mic-e/debugger9k1/board_v2/history.md

3 pcs ordered from Aisler at 2021-11-27
5 pcs ordered from JLCPCB at 2021-11-28

1 pc (Aisler) assembled at march - may 2022
