mic-e/debugger9k1/board_v2/board.kicad_pcb

## KiCad design board_v2/board.kicad_pcb (2022-05-30)

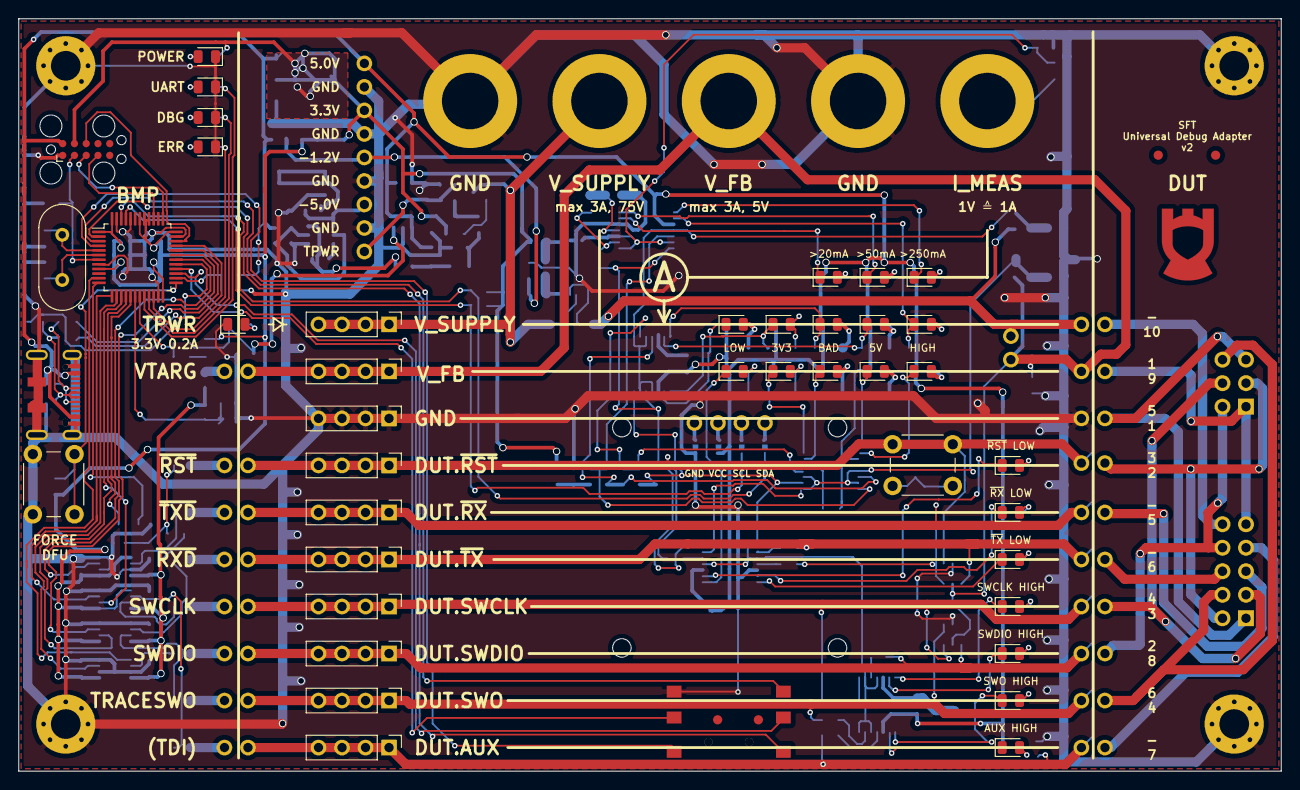
[picture p1: board board.kicad_pcb from above]

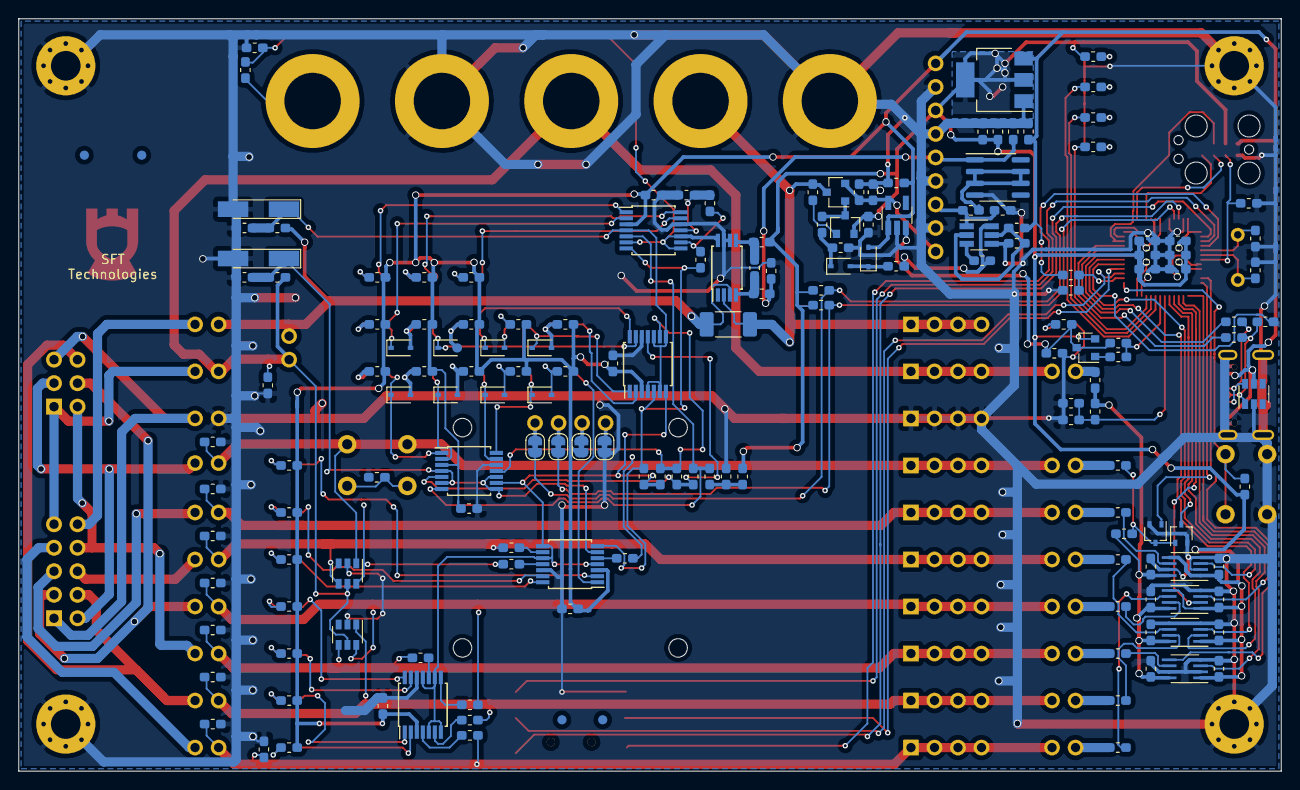
[picture p2: board board.kicad_pcb from below]

Board: 2 copper layers, 136.4 x 81.3 mm, 246 parts (167 on the bottom side), 157 nets.

Parts:
C1, C5, C7, C8, C9, C10, C11, C12, C13, C14, C15, C16, C17, C18, C19, C20, C21, C22, C23, C24, C25, C33, C34, C35, C36: 100nF; C_0603_1608Metric_Pad1.05x0.95mm_HandSolder
C2, C3: 18pF; C_0603_1608Metric_Pad1.05x0.95mm_HandSolder
C4, C6, C26, C29, C30, C31: 4.7uF; C_0603_1608Metric_Pad1.05x0.95mm_HandSolder
C27, C28: 10uF; C_0603_1608Metric_Pad1.05x0.95mm_HandSolder
C32: 1uF; C_0603_1608Metric_Pad1.05x0.95mm_HandSolder
D1, D6, D8, D15, D18, D20, D39: Green; LED_0805_2012Metric
D2, D3, D9, D10, D11, D14, D22, D23, D24, D25: Yellow; LED_0805_2012Metric
D4, D5, D7, D12, D13, D17, D19, D21: Red; LED_0805_2012Metric
D16, D26: 4.7V; D_MiniMELF_Handsoldering
D27, D29, D38: 24V ESD; R_0603_1608Metric_Pad1.05x0.95mm_HandSolder
D30, D31, D32, D33, D34, D35, D36, D37, D40, D41: 1N4148WS; D_SOD-323
FB1, FB2, FB3, FB4, FB5: 30Ω@100MHz; R_0603_1608Metric_Pad1.05x0.95mm_HandSolder
FID1, FID2, FID3, FID4, FID5, FID6, FID7, FID8: Fiducial; Fiducial_1mm_Mask2mm
H1, H2, H3, H4: MountingHole_Pad; MountingHole_3.2mm_M3_Pad_Via
J1: DX07S016JA; USB_C_JAE_DX07S0116JA1
J3, J4, J5, J6, J7, J8, J9, J10, J11, J12: Conn_01x04_Male; PinHeader_1x04_P2.54mm_Vertical
J13, J14, J15, J16, J17: Conn_01x01_Female; Connector_Banana_SKS_BIL20
J18: Conn_01x09; PinHeader_1x09_P2.54mm_Vertical
JP1, JP2, JP3, JP4, JP5, JP6, JP7, JP8, JP9, JP10, JP11, JP12, JP13, JP14, JP15, JP16, JP17, JP18, JP19: Jumper_NC_Small; Jumper_2.54mm
JP20, JP21, JP22, JP23: SolderJumper_2_Bridged; SolderJumper-2_P1.3mm_Bridged_RoundedPad1.0x1.5mm
LOGO1: Logo; LOGO_CU_070
Q1, Q2: N-Channel; SOT-323_SC-70
Q3: BC857B; SOT-23
Q4: N-Channel; SOT-23
Q5: BC848B; SOT-23
R1, R5, R7, R9, R50, R51, R61, R62, R72, R74, R76: 10k; R_0603_1608Metric_Pad1.05x0.95mm_HandSolder
R2, R11, R20, R21: 1k5; R_0603_1608Metric_Pad1.05x0.95mm_HandSolder
R3, R4: 22; R_0603_1608Metric_Pad1.05x0.95mm_HandSolder
R6, R8, R70, R71: 4k7; R_0603_1608Metric_Pad1.05x0.95mm_HandSolder
R10, R75: 15k; R_0603_1608Metric_Pad1.05x0.95mm_HandSolder
R12, R13, R14, R15, R16, R17, R18, R19: 100; R_0603_1608Metric_Pad1.05x0.95mm_HandSolder
R22: 50mOhm; R_2010_5025Metric_Pad1.52x2.65mm_HandSolder
R23, R36, R38, R43, R53, R55: 33k; R_0603_1608Metric_Pad1.05x0.95mm_HandSolder
R24: 30k; R_0603_1608Metric_Pad1.05x0.95mm_HandSolder
R25: 27k; R_0603_1608Metric_Pad1.05x0.95mm_HandSolder
R26: 18k; R_0603_1608Metric_Pad1.05x0.95mm_HandSolder
R27: 75k; R_0603_1608Metric_Pad1.05x0.95mm_HandSolder
R28: 12k; R_0603_1608Metric_Pad1.05x0.95mm_HandSolder
R29: 1k8; R_0603_1608Metric_Pad1.05x0.95mm_HandSolder
R30: 1k2; R_0603_1608Metric_Pad1.05x0.95mm_HandSolder
R31, R32, R33, R46, R47, R48, R49, R77, R78: 100k; R_0603_1608Metric_Pad1.05x0.95mm_HandSolder
R34, R81: 200; R_0603_1608Metric_Pad1.05x0.95mm_HandSolder
R35, R37, R39, R40, R41, R42, R44, R45, R52, R54, R56, R57, R58, R59, R60, R79: 3k3; R_0603_1608Metric_Pad1.05x0.95mm_HandSolder
R63, R64, R65, R66, R67, R68, R69: 1M; R_0603_1608Metric_Pad1.05x0.95mm_HandSolder
R73: 0; R_0603_1608Metric_Pad1.05x0.95mm_HandSolder
R80: 330; R_0603_1608Metric_Pad1.05x0.95mm_HandSolder
SW1, SW2: SW_Push; SW_PUSH_6mm_H4.3mm
SW3: K1-1504SA-03
U1: STM32F103CBTx; LQFP-48_7x7mm_P0.5mm
U2, U3, U5, U6: SN74LVC2T45DCT; TI-R-PDSO-G8
U4, U13, U14: USBLC6-4SC6; SOT-23-6
U7: INA240A1; TSSOP-8_4.4x3mm_P0.65mm
U8, U9, U10, U11, U12: TS339; TSSOP-14_4.4x5mm_P0.65mm
U15: NCP1117-3.3; SOT-223-3_TabPin2
U16: SGM3204; SOT-23-6_Handsoldering
U17: LM337L; SOIC-8_3.9x4.9mm_P1.27mm
U18: TLV70033; SOT-23-5_HandSoldering
X1: SFT_DEBUG_CONNECTOR-SELF; Tag-Connect_TC2050-IDC-FP_2x05_P1.27mm_Vertical
X2: SFT debugport; IDC-Header_2x05_P2.54mm_Vertical
X3: ARM debugport; IDC-Header_2x03_P2.54mm_Vertical
X4: Blue; OLED_128x64_096in
Y1: 8.000 MHz; Crystal_HC49-4H_Vertical

Connections:
+3V3: C4.2, C5.2, C6.2, C7.2, C8.2, C9.2, C12.2, C13.2, C14.2, C15.2, C28.2, C32.2, FB1.1, FB3.1, J18.3, Q3.2, Q5.2, R5.2, R10.1, R70.1, R71.1, R79.1, U1.1, U1.9, U1.24, U1.36, U1.40, U1.41, U1.42, U1.48, U2.1, U2.5, U3.1, U3.5, U5.1, U6.1, U15.2, X1.9
+5V: C21.1, C22.1, C23.1, C24.1, C25.1, C27.2, C33.1, D40.2, FB4.1, J1.A4/B9, J1.B4/A9, J18.1, JP22.2, R6.1, R35.1, R36.1, R37.1, R38.1, R39.1, R40.1, R41.1, R42.1, R43.1, R44.1, R45.1, R52.1, R53.1, R54.1, R55.1, R56.1, R57.1, R58.1, R59.1, R60.1, U4.5, U8.3, U9.3, U10.3, U11.3, U12.3, U15.3, U18.1, X1.10
-1V2: C31.2, FB2.2, J18.5, R80.1, U17.1
-5V: C30.2, FB5.1, J18.7, U16.1
/BlackMagicProbe/BMP.RXD: J4.1, J4.2, J4.3, J4.4, JP9.1, JP13.1, R31.2, R65.1, U13.4
/BlackMagicProbe/BMP.SWCLK: J6.1, J6.2, J6.3, J6.4, JP6.1, JP16.1, R47.2, R66.1, U14.6
/BlackMagicProbe/BMP.SWDIO: J8.1, J8.2, J8.3, J8.4, JP7.1, JP17.1, R48.2, R67.1, U14.4
/BlackMagicProbe/BMP.TDI: D27.1, J12.1, J12.2, J12.3, J12.4, JP4.1, JP19.1, R49.2, R69.1
/BlackMagicProbe/BMP.TRACESWO: J10.1, J10.2, J10.3, J10.4, JP5.1, JP18.1, R46.2, R68.1, U14.1
/BlackMagicProbe/BMP.TXD: J11.1, J11.2, J11.3, J11.4, JP8.1, JP14.1, R32.2, R64.1, U13.6
/BlackMagicProbe/BMP.VTARG: D29.1, J7.1, J7.2, J7.3, J7.4, J14.1, JP1.2, JP2.1, JP12.1, R61.1, U13.5, U14.5
/BlackMagicProbe/BMP.~RST: J9.1, J9.2, J9.3, J9.4, JP3.1, JP15.1, R33.2, R63.1, SW1.1, U13.1
/BlackMagicProbe/BMP.~TPWR_EN: R72.1, R73.1, U1.19
/BlackMagicProbe/FORCE_DFU: R5.1, SW2.1, U1.25
/BlackMagicProbe/INTERFACE_NATIVE_RST: Q1.1, U1.12
/BlackMagicProbe/INTERFACE_NATIVE_RST_SENSE: Q2.3, U1.17
/BlackMagicProbe/INTERFACE_NATIVE_RXD: U1.31, U6.3
/BlackMagicProbe/INTERFACE_NATIVE_SWDIO_DIR: U1.11, U5.5
/BlackMagicProbe/INTERFACE_NATIVE_TCK_SWCLK: U1.15, U3.2
/BlackMagicProbe/INTERFACE_NATIVE_TDI: U1.13, U3.3
/BlackMagicProbe/INTERFACE_NATIVE_TDO_TRACESWO: U1.16, U6.2
/BlackMagicProbe/INTERFACE_NATIVE_TMS_SWDIO: U1.14, U5.3
/BlackMagicProbe/INTERFACE_NATIVE_TXD: U1.30, U2.3
/BlackMagicProbe/INTERFACE_TARGET_RXD: R19.2, U6.6
/BlackMagicProbe/INTERFACE_TARGET_TCK_SWCLK: R16.2, U3.7
/BlackMagicProbe/INTERFACE_TARGET_TDI: R14.2, U3.6
/BlackMagicProbe/INTERFACE_TARGET_TDO_TRACESWO: R15.2, U6.7
/BlackMagicProbe/INTERFACE_TARGET_TMS_SWDIO: R17.2, U5.6
/BlackMagicProbe/INTERFACE_TARGET_TXD: R18.2, U2.6
/BlackMagicProbe/INTERFACE_TARGET_~RST: Q1.3, Q2.1, R1.2, R13.2
/BlackMagicProbe/LED0: R11.1, U1.20
/BlackMagicProbe/LED1: R20.1, U1.21
/BlackMagicProbe/LED2: R21.1, U1.22
/BlackMagicProbe/SELF_SWCLK: U1.37, X1.3
/BlackMagicProbe/SELF_SWDIO: U1.34, X1.8
/BlackMagicProbe/SELF_TRACESWO: U1.39, X1.4
/BlackMagicProbe/SELF_~RST: C1.1, U1.7, X1.2
/BlackMagicProbe/UI.SCL: JP20.1, R70.2, U1.45
/BlackMagicProbe/UI.SDA: JP21.1, R71.2, U1.46
/BlackMagicProbe/UI.~BUTTON_DOWN: SW3.4, U1.3
/BlackMagicProbe/UI.~BUTTON_LEFT: SW3.5, U1.27
/BlackMagicProbe/UI.~BUTTON_PRESS: SW3.3, U1.4
/BlackMagicProbe/UI.~BUTTON_RIGHT: SW3.2, U1.28
/BlackMagicProbe/UI.~BUTTON_UP: SW3.6, U1.2
/BlackMagicProbe/USB+: R4.2, U1.33
/BlackMagicProbe/USB-: R3.2, U1.32
/BlackMagicProbe/USB_1K5_PULLUP_CTRL: R2.2, U1.29
/BlackMagicProbe/USB_D+: J1.A6, J1.B6, R2.1, R4.1, U4.1
/BlackMagicProbe/USB_D-: J1.A7, J1.B7, R3.1, U4.6
/BlackMagicProbe/VBUS_MEAS: R6.2, R7.1, U1.26
/BlackMagicProbe/VTARG: C10.1, C11.1, C16.1, C17.1, R1.1, R8.1, R12.2, U2.8, U3.8, U5.8, U6.8
/BlackMagicProbe/VTARG_MEAS: C18.2, R8.2, R9.1, U1.18
/OutputInterface/3V3_FILTERED: C19.1, FB1.2, U7.5
/OutputInterface/-1V2_FILTERED: C19.2, FB2.1, U7.4
/OutputInterface/DUT.V_SUPPLY: J5.1, J5.2, J5.3, J5.4, J13.1, Q4.3, R22.2, R78.2, U7.2
/OutputInterface/I_SUPPLY: D38.1, R81.2, U7.8, U10.6, U10.8, U10.10
/OutputInterface/VREF_20mV: R29.2, R30.1, U10.11
/OutputInterface/VREF_50mV: R28.2, R29.1, U10.9
/OutputInterface/VREF_250mV: R27.2, R28.1, U8.5, U9.7, U10.7
/OutputInterface/VREF_1500mV: R26.2, R27.1, U8.7, U9.4, U9.8, U9.10, U11.9, U12.5, U12.7, U12.9, U12.11
/OutputInterface/VREF_1800mV: R25.2, R26.1, U8.9, U11.11
/OutputInterface/VREF_2250mV: R24.2, R25.1, U8.11, U11.5
/OutputInterface/VREF_2750mV: R23.1, R24.1, U10.5, U11.7
/OutputInterface/VREF_3300mV: C20.1, FB3.2, R23.2
/OutputInterface/V_FB_DIVIDED: D26.1, R61.2, R62.1, U9.6, U11.4, U11.6, U11.8, U11.10
/OutputInterface/V_SUPPLY: JP1.1, JP11.1, R22.1, R50.1, U7.3
/OutputInterface/V_SUPPLY_DIVIDED: D16.1, R50.2, R51.1, U8.4, U8.6, U8.8, U8.10, U10.4
/Power/3V3_TPWR: C35.1, J18.9, Q4.2, R76.1, U18.5
/Power/CFLY+: C29.2, C34.1, U16.6
GND: C1.2, C2.2, C3.2, C4.1, C5.1, C6.1, C7.1, C8.1, C9.1, C10.2, C11.2, C12.1, C13.1, C14.1, C15.1, C16.2, C17.2, C18.1, C20.2, C21.2, C22.2, C23.2, C24.2, C25.2, C26.1, C27.1, C28.1, C30.1, C31.1, C32.1, C33.2, C35.2, C36.1, D1.1, D2.1, D3.1, D4.1, D16.2, D26.2, D27.2, D29.2, D38.2, D39.1, H1.1, H2.1, H3.1, H4.1, J1.A1/B12, J1.B1/A12, J1.S1, J3.1, J3.2, J3.3, J3.4, J16.1, J17.1, J18.2, J18.4, J18.6, J18.8, JP10.1, JP23.2, Q1.2, Q2.2, R7.2, R9.2, R30.2, R34.1, R51.2, R62.2, R63.2, R64.2, R65.2, R66.2, R67.2, R68.2, R69.2, R74.2, R76.2, R79.2, R80.2, SW2.2, SW3.1, U1.8, U1.23, U1.35, U1.44, U1.47, U2.2, U2.4, U2.7, U3.4, U4.2, U5.2, U5.4, U5.7, U6.4, U6.5, U7.6, U7.7, U8.12, U9.12, U10.12, U11.12, U12.12, U13.2, U14.2, U15.1, U16.4, U17.4, U18.2, X1.1
unnamed: C2.1, U1.5, Y1.1
unnamed: C3.1, U1.6, Y1.2
unnamed: C26.2, FB4.2, U16.2, U16.5
unnamed: C29.1, U16.3
unnamed: C34.2, D40.1, D41.2
unnamed: C36.2, D41.1, R77.2
unnamed: D1.2, R10.2
unnamed: D2.2, R11.2
unnamed: D3.2, R20.2
unnamed: D4.2, R21.2
unnamed: D5.1, U8.2
unnamed: D9.2, R39.2
unnamed: D10.1, U9.14
unnamed: D10.2, R40.2
unnamed: D11.1, U9.13
unnamed: D11.2, R41.2
unnamed: D12.1, U9.2
unnamed: D12.2, R42.2
unnamed: D13.1, U10.1
unnamed: D13.2, R43.2
unnamed: D14.1, U10.14
unnamed: D14.2, R44.2
unnamed: D15.1, U10.13
unnamed: D15.2, R45.2
unnamed: D17.1, U9.1
unnamed: D17.2, D34.2, R52.2
unnamed: D18.1, D34.1, U11.14
unnamed: D18.2, D35.2, R53.2
unnamed: D19.1, D35.1, U11.13
unnamed: D19.2, D36.2, R54.2
unnamed: D20.1, D36.1, U11.2
unnamed: D20.2, D37.2, R55.2
unnamed: D21.1, D37.1, U11.1
unnamed: D21.2, R56.2
unnamed: D22.1, U12.1
unnamed: D22.2, R57.2
unnamed: D23.1, U12.14
unnamed: D23.2, R58.2
unnamed: D24.1, U12.13
unnamed: D24.2, R59.2
unnamed: D25.1, U12.2
unnamed: D25.2, R60.2
unnamed: D6.1, D30.1, U8.1
unnamed: D5.2, D30.2, R35.2
unnamed: D7.1, D31.1, U8.14
unnamed: D6.2, D31.2, R36.2
unnamed: D8.1, D32.1, U8.13
unnamed: D7.2, D32.2, R37.2
unnamed: D9.1, D33.1, U10.2
unnamed: D8.2, D33.2, R38.2
unnamed: D39.2, R75.2
unnamed: FB5.2, U17.2, U17.3, U17.6, U17.7
unnamed: J15.1, R81.1
unnamed: JP2.2, R12.1
unnamed: JP3.2, R13.1
unnamed: JP4.2, R14.1
unnamed: JP5.2, R15.1
unnamed: JP6.2, R16.1
unnamed: JP7.2, R17.1
unnamed: JP8.2, R18.1
unnamed: JP9.2, R19.1
unnamed: JP10.2, X2.1, X3.5
unnamed: JP11.2, X2.10
unnamed: JP12.2, X2.9, X3.1
unnamed: JP13.2, X2.6
unnamed: JP14.2, X2.5
unnamed: JP15.2, X2.2, X3.3
unnamed: JP16.2, X2.3, X3.4
unnamed: JP17.2, X2.8, X3.2
unnamed: JP18.2, X2.4, X3.6
unnamed: JP19.2, X2.7
unnamed: JP20.2, X4.3
unnamed: JP21.2, X4.4
unnamed: JP22.1, X4.2
unnamed: JP23.1, X4.1
unnamed: Q3.1, R72.2
unnamed: Q3.3, R73.2, R74.1, R75.1, U18.3
unnamed: Q4.1, Q5.3, R77.1
unnamed: Q5.1, R78.1
unnamed: R31.1, U9.9
unnamed: R32.1, U9.11
unnamed: R33.1, U9.5
unnamed: R34.2, SW1.2
unnamed: R46.1, U12.6
unnamed: R47.1, U12.8
unnamed: R48.1, U12.10
unnamed: R49.1, U12.4
