mic-e/debugger9k1/board_v2/issues-and-improvements.md

# schematic

- bug: missing pulldown resistors on USB-C CC lines
- feature request: TPWR 5V
- feature request: holes in addition to headers for the lines (this is just a silk layer change)
- feature request: RESET button
- feature request: firmware: display support
- feature request: firmware: set default freq = 1 MHz
- feature request: contact for +10V
- bug: when TPWR=off, connecting +5V to V_SUPPLY and disconnecting it again kills the LDO U18
- feature request: zener diode to protect usblc6

# testing

- test whether display works

# components

- contact between bil20 and gold ring is bad... need some sort of contact pad?
