mic-e/debugger9k1/(commit log)

2021-11-27 Release board v2
    [BlackMagicProbe.sch, OutputInterface.sch, Power.sch, UserInterface.sch, adapter.kicad_pcb, adapter.sch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]
2022-05-30 Add issues and improvements for boardv2
2022-05-30 Add history to boardv2
2022-05-30 Port sch and brd to kicad6
    [BlackMagicProbe.kicad_sch, OutputInterface.kicad_sch, Power.kicad_sch, UserInterface.kicad_sch, board.kicad_pcb, board.kicad_sch]
2022-05-30 Clean up kicad5 files in board_v2
    [BlackMagicProbe.kicad_sch, BlackMagicProbe.sch, OutputInterface.kicad_sch, OutputInterface.sch, Power.kicad_sch, Power.sch, UserInterface.kicad_sch, UserInterface.sch]
2022-07-02 Update board v2 evaluation
